WaggishSaucer62/R53-CANBUS-datamanager/PCB files and 3D models/PCBs/powerFilter/powerFilterBOM.xlsx

No. | Quantity | Comment | Designator | Footprint | Value | Manufacturer Part | Manufacturer | Supplier Part | Supplier
1 | 3 | 100nF | C7,C8,C9 | C0603 | 100nF | CC0603KRX7R9BB104 | YAGEO(国巨) | C14663 | LCSC
2 | 8 | 22uF | C11,C12,C13,C14,C15,C16,C17,C18 | C1206 | 22uF | CL31A226KAHNNNE | SAMSUNG(三星) | C12891 | LCSC
3 | 1 | SS14 | D1 | SMA_L4.2-W2.6-LS5.0-RD_1 |  | SS14 | MDD(辰达半导体) | C2480 | LCSC
4 | 2 | 47uH | L1,L2 | IND-SMD_L7.3-W6.8 | 47uH | FXL0650-470-M | cjiang(长江微电) | C475527 | LCSC
