WaggishSaucer62/R53-CANBUS-datamanager/PCB files and 3D models/3D models/TPUprotectionSpacer.obj

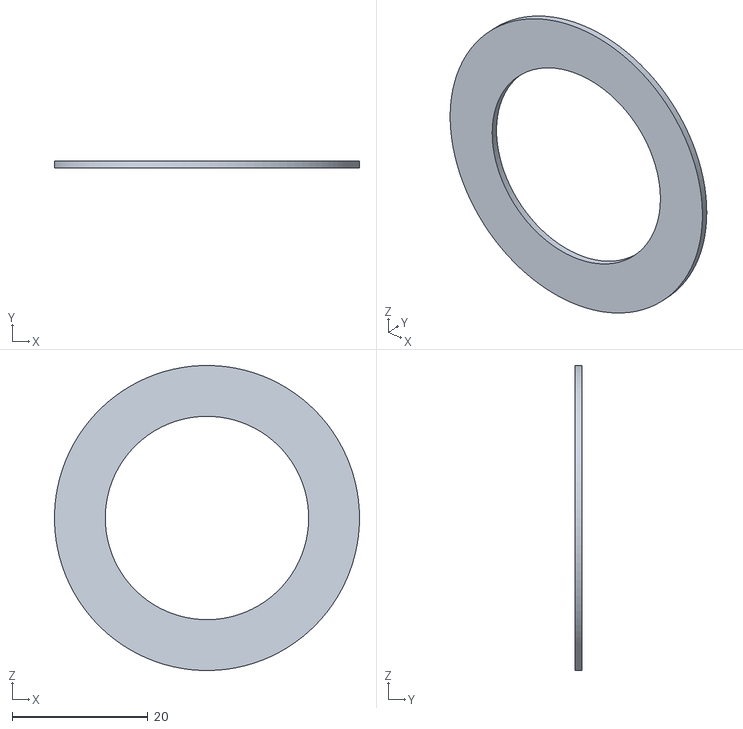
[picture p1: CAD file, 2025-12-04]
PCB files and 3D models/3D models/TPUprotectionSpacer.obj
45.0 x 1.00 x 45.0
