WaggishSaucer62/R53-CANBUS-datamanager/PCB files and 3D models/3D models/lockingCollar.obj

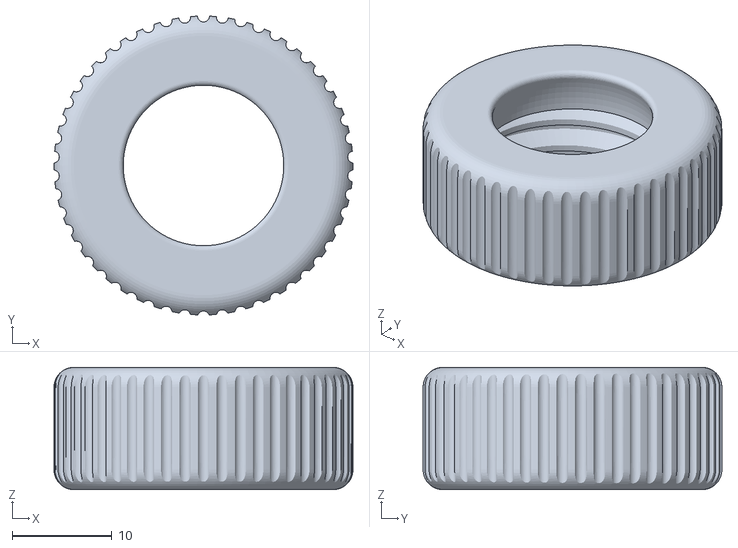
[picture p2: CAD file, 2025-12-04]
PCB files and 3D models/3D models/lockingCollar.obj
30.0 x 30.0 x 12.3
