WaggishSaucer62/R53-CANBUS-datamanager/PCB files and 3D models/3D models/ventSocketMount.obj

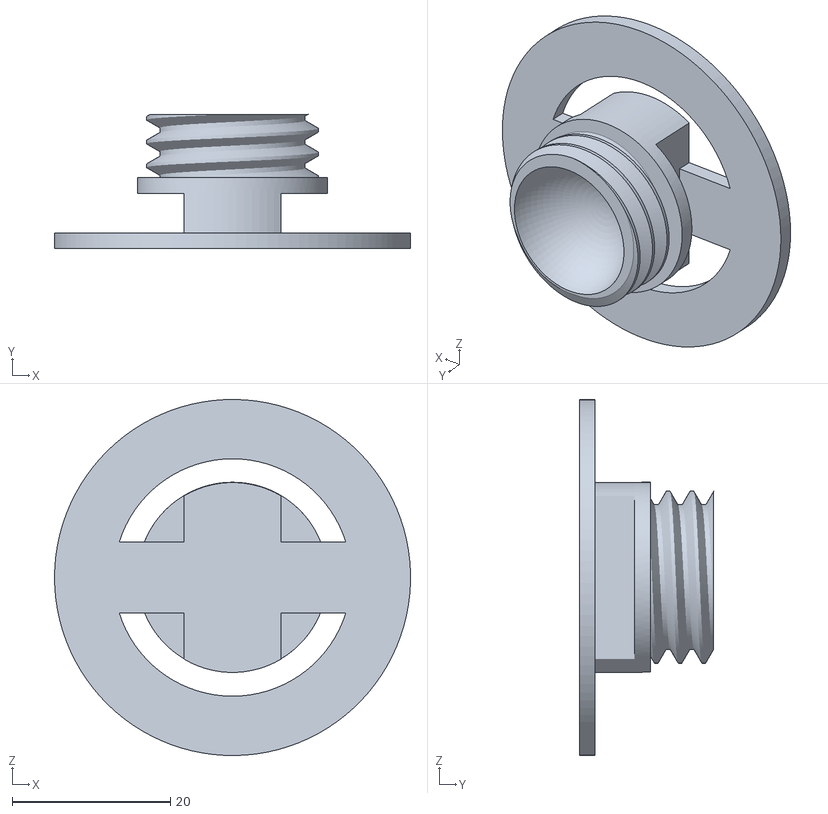
[picture p3: CAD file, 2025-12-04]
PCB files and 3D models/3D models/ventSocketMount.obj
45.0 x 17.0 x 45.0
