WaggishSaucer62/R53-CANBUS-datamanager/PCB files and 3D models/3D models/screenFrontPlate.obj

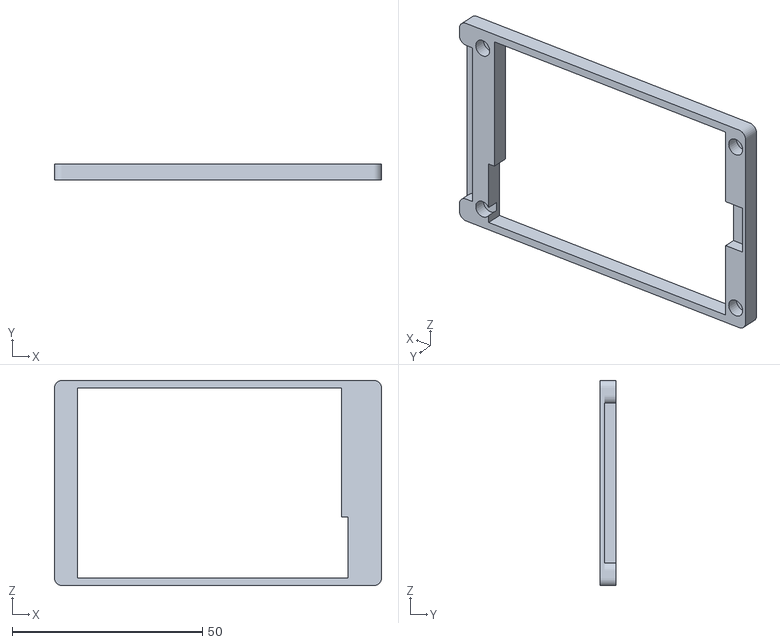
[picture p4: CAD file, 2025-12-04]
PCB files and 3D models/3D models/screenFrontPlate.obj
86.0 x 4.20 x 54.0
