WaggishSaucer62/R53-CANBUS-datamanager/PCB files and 3D models/3D models/screenRearPlate.obj

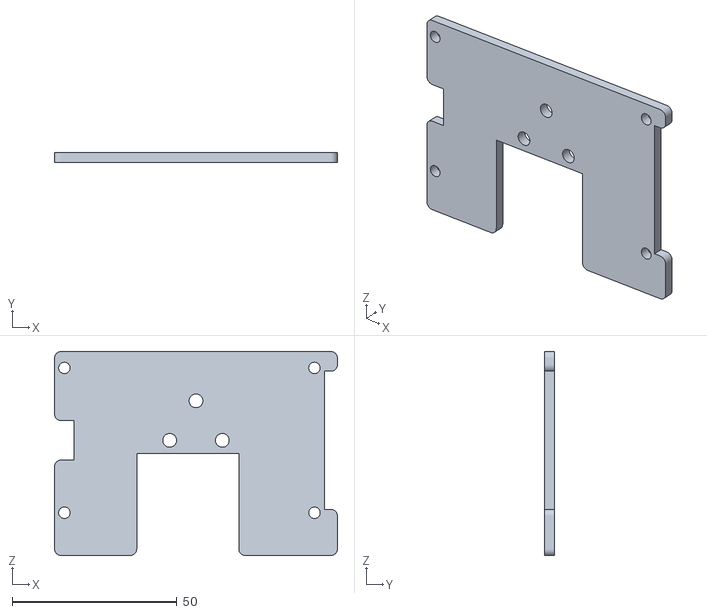
[picture p5: CAD file, 2025-12-04]
PCB files and 3D models/3D models/screenRearPlate.obj
86.0 x 3.00 x 62.0
