WaggishSaucer62/R53-CANBUS-datamanager/PCB files and 3D models/3D models/ballMount.obj

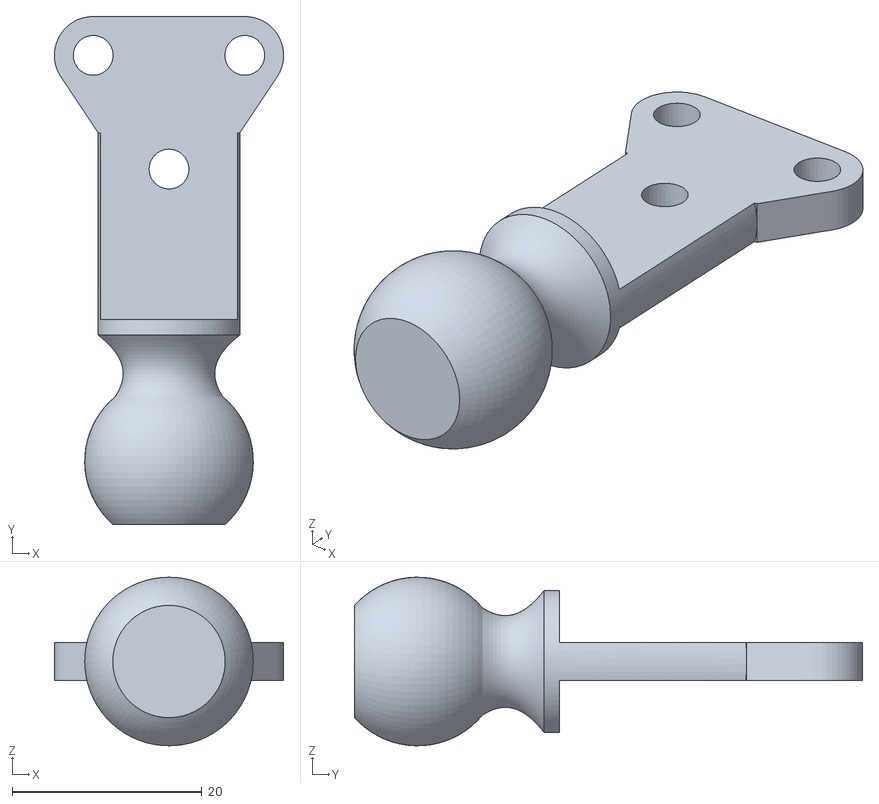
[picture p6: CAD file, 2025-12-04]
PCB files and 3D models/3D models/ballMount.obj
24.2 x 53.6 x 17.8
