WaggishSaucer62/R53-CANBUS-datamanager/PCB files and 3D models/PCBs/mainPCB/mainPCBwiringSchematicV1.1+.pdf

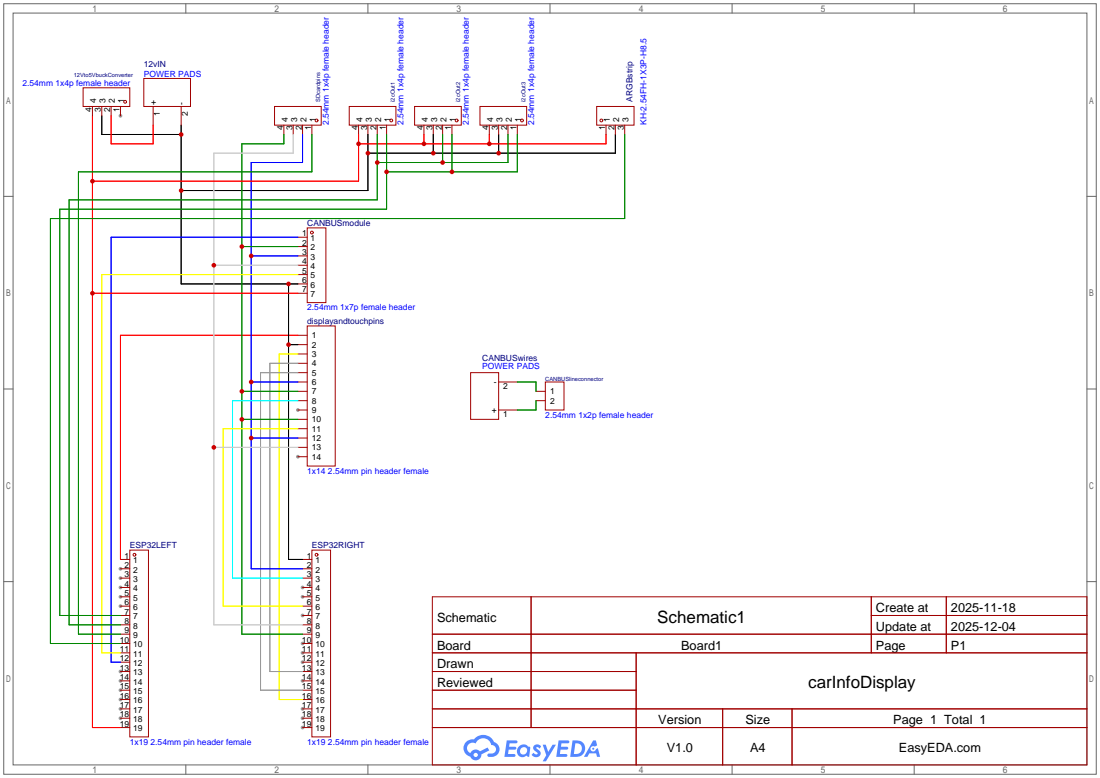
[picture p7: page 1]

Board | Board1 | Page | P1
Drawn | | carInfoDisplay
Reviewed

Version | Size | Page 1 Total 1
V1.0 | A4 | EasyEDA.com
