WaggishSaucer62/R53-CANBUS-datamanager/(list of files, drawings)

Other design files:
PCB files and 3D models/PCBs/mainPCB/CANBUSdataLoggerProjectFileV1.2.epro
