WaggishSaucer62/R53-CANBUS-datamanager/include/globals.h

/*
Header file for defining global variables and constants for use in other files.
WaggishSaucer62, 27/11/25
*/

#pragma once
#include <iostream>
#include <Arduino.h>
#include <TFT_eSPI.h>
#include <mcp_can.h>
#include <SPI.h>
#include <string>
#include <FastLED.h>
#include <SD.h>
#include <map>
#include <string>
#include <variant>
#include <deque>
#include <cstdint>


#define MCP_CS 27
#define TFT_CS 15
#define TOUCH_CS 21
#define SD_CS 25
#define DARKER_GREY 0x18E3

#define NUM_LEDS 5
#define LED_DATA_PIN 26

extern CRGB leds[NUM_LEDS];

extern MCP_CAN CAN;
extern TFT_eSPI tft;

enum screenID {
    MAIN_SCREEN,
    SETTINGS_SCREEN,
    POWER_SCREEN,
    ACCEL_SCREEN
};
extern screenID currentScreen;

extern uint16_t xTouch;
extern uint16_t yTouch;
extern bool pressed;

extern int brightnessPercentage;
extern int LEDbrightnessPercentage;

extern bool lastPressedState;

extern int fuelWarningLevel;

extern int autoLoggingThreshold;

extern int stopDrawForMillis;
extern bool reinit;

extern bool hibernate;


#include "arcDial.hpp"
#include "verticalBarGauge.hpp"
#include "shiftCueDots.hpp"
#include "textLabel.hpp"
#include "button.hpp"
#include "verticalSlider.hpp"
#include "rollingGraph.hpp"
#include "CANBUS.hpp"
#include "sdCard.hpp"
#include "shiftCueDotsLED.hpp"
#include "configManager.hpp"
#include "loggingManager.hpp"
#include "powerCalculator.hpp"
#include "slidingMax.hpp"


extern arcDial rpmDial;
extern verticalBar fuelGauge;
extern verticalBar throttleGauge;
extern shiftCueDots shiftDots;
extern textLabel tempText;
extern textLabel powerText;
extern textLabel powerPeakText;
extern textLabel coolantTemp;
extern button loggingToggle;
extern button autoLoggingToggle;
extern verticalSlider brightnessSlider;
extern verticalSlider LEDbrightnessSlider;
extern rollingGraph powerGraph;
extern CANBUS canBus;
extern SDCardReader sd;
extern shiftCueDotsLED shiftDotsLED;
extern configManager config;
extern loggingManager logger;
extern loggingManager autoLogger;
extern powerCalculator powerCalc;
extern slidingMax hpMax;


extern button accelStartSpeedUp;
extern button accelStartSpeedDown;
extern button accelStartSpeedPreset1;
extern button accelStartSpeedPreset2;
extern button accelStartSpeedPreset3;
extern button accelStartSpeedPreset4;

extern button accelEndSpeedUp;
extern button accelEndSpeedDown;
extern button accelEndSpeedPreset1;
extern button accelEndSpeedPreset2;
extern button accelEndSpeedPreset3;
extern button accelEndSpeedPreset4;

extern textLabel accelStartSpeedText;
extern textLabel accelEndSpeedText;
extern textLabel accelStartText;
extern textLabel accelEndText;
extern textLabel accelTime;
