WaggishSaucer62/R53-CANBUS-datamanager/src/globals.cpp

/*
File for defining all global variables
WaggishSaucer62, 27/11/25
*/

#include "globals.h"
#include "functions.h"


MCP_CAN CAN(MCP_CS);
TFT_eSPI tft = TFT_eSPI();

CRGB leds[NUM_LEDS];


screenID currentScreen = MAIN_SCREEN;

uint16_t xTouch;
uint16_t yTouch;
bool pressed = false;


int brightnessPercentage = 100;
int LEDbrightnessPercentage = 100;

bool lastPressedState = false;

int fuelWarningLevel = 5;

int autoLoggingThreshold = 70;

int stopDrawForMillis = 0;
bool reinit = false;

bool hibernate = false;

arcDial rpmDial;
verticalBar fuelGauge;
verticalBar throttleGauge;
shiftCueDots shiftDots;
textLabel tempText;
textLabel powerText;
textLabel powerPeakText;
textLabel coolantTemp;
button loggingToggle;
button autoLoggingToggle;
verticalSlider brightnessSlider;
verticalSlider LEDbrightnessSlider;
rollingGraph powerGraph(tft, 10, 150, 300, 80, 0, 200);
CANBUS canBus;
SDCardReader sd(SD);
shiftCueDotsLED shiftDotsLED;
configManager config(sd);
loggingManager logger(sd);
loggingManager autoLogger(sd);
powerCalculator powerCalc(canBus);
slidingMax hpMax;



button accelStartSpeedUp;
button accelStartSpeedDown;
button accelStartSpeedPreset1;
button accelStartSpeedPreset2;
button accelStartSpeedPreset3;
button accelStartSpeedPreset4;

button accelEndSpeedUp;
button accelEndSpeedDown;
button accelEndSpeedPreset1;
button accelEndSpeedPreset2;
button accelEndSpeedPreset3;
button accelEndSpeedPreset4;

textLabel accelStartSpeedText;
textLabel accelEndSpeedText;
textLabel accelStartText;
textLabel accelEndText;
textLabel accelTime;
