WaggishSaucer62/R53-CANBUS-datamanager/(commit log)

2025-11-27 fixed logic errors with emptying CAN buffer and writing values to main gauge
    [CANBUS.hpp, arcDial.hpp, main.cpp]
2025-11-30 Start LED support, switch textLabel to use str, add power debug prints
2025-12-01 change speed scaling factor, fix logic bug in power screen
    [CANBUS.hpp, screens.cpp]
2025-12-01 added init code for power screen
2025-12-04 clarified magic numbers, made CAN fail non blocking
    [main.cpp]
2025-12-04 LED support work, fix logic errors, change how shift cue dot states are changed,
    [globals.cpp, globals.h, main.cpp, shiftCueDots.hpp, shiftCueDotsLED.hpp]
2025-12-04 Added credit for ball joint before uploading models
2025-12-04 Added files for PCBs and prints
    [CANBUSdataLoggerProjectFile.epro, TPUprotectionSpacer.obj, ballMount.obj, lockingCollar.obj, screenFrontPlate.obj, screenRearPlate.obj, ventSocketMount.obj]
2025-12-05 update todo, add LED_COUNT precomilation clarifier
2025-12-05 Add ARGB strip support, config file, associated wrappers and code.
    [config.cfg]
2025-12-06 Add logging functionality, move power calculation to a class, add init method to rollingGraph
    [config.cfg]
2025-12-07 removed persistent logging state, now always set to off on boot, added saving message, made logging saves safer to avoid corruption.
    [config.cfg]
2025-12-07 updated PCBs V1.2
    [CANBUSdataLoggerProjectFile.epro, CANBUSdataLoggerProjectFileV1.2.epro]
2025-12-08 fix logic error with loggingToggle init state, constantly resetting lastDraw to 0, and moved powerCalc line to loop so logs still update
    [button.hpp, main.cpp, screens.cpp]
2025-12-08 add and organize power filter pcb
    [CANBUSdataLoggerProjectFileV1.2.epro, powerFilterBOM.xlsx, powerFilterPickAndPlace.xlsx]
2025-12-09 fixed error causing an extra comma in logs
    [loggingManager.hpp]
2025-12-09 added fuel warning
    [config.cfg]
2025-12-09 added warnings for can and sd init fail
    [functions.cpp, main.cpp]
2025-12-09 fixed repeated fuel warnings bug
    [main.cpp]
2025-12-09 Fixed extra comma bug in logs
    [loggingManager.hpp]
2025-12-10 Made warnings non blocking, added autologging when throttle exceeds a threshold
    [config.cfg]
2025-12-11 changed to close autolog after a configurable amount of time, added newline at end of config as required by load function.
    [config.cfg]
2025-12-13 Fixed rounding error in timestamps for logs, added labels to sliders, changed how logs are managed to reduce corruption
    [loggingManager.hpp, main.cpp, verticalSlider.hpp]
2025-12-17 update logic error causing data to not be logged when throttle under logging threshold but autologging active
    [main.cpp]
2025-12-17 Fixed bugs causing logging messages to remain on screen if on the power screen, fixed blanking width for textLabel class
    [screens.cpp, textLabel.hpp]
2025-12-24 changed power smoothing to make it more accurate, changed what happens with speed when it cannot be determined
2025-12-24 fix error - forgot to delete line
    [loggingManager.hpp]
2025-12-30 removed smoothed power, should be more accurate, but graphs will be less smooth
2026-01-12 Moved powerCalc to update on all screens
    [config.cfg]
2026-01-18 started decoding CAN frames, added coolant temp
2026-02-09 add auto power toggle
    automatically turns on/off,
    fix speed blanking sometimes,
    change speed scaling factor to better match GPS
    [CANBUS.hpp, arcDial.hpp, globals.cpp, globals.h, main.cpp, screens.cpp]
2026-04-16 added accel screen to initialisation switch case
